DKESTXD/qiangao-mozhang/mozhang/classifier.h

#pragma once
#include <cstdarg>
namespace Eloquent {
    namespace ML {
        namespace Port {
            class SVM {
                public:
                    /**
                    * Predict class for features vector
                    */
                    int predict(float *x) {
                        float kernels[124] = { 0 };
                        float decisions[6] = { 0 };
                        int votes[4] = { 0 };
                        kernels[0] = compute_kernel(x,   -0.0  , 0.0  , 0.0  , 0.01  , 0.03  , 0.06  , 0.1  , 0.09  , 0.1  , 0.13  , 0.0  , 0.0  , 0.0  , 0.0  , 0.0  , 0.0  , 0.0  , 0.0  , 0.0  , 0.0  , 0.0  , 0.0  , 0.0  , 0.0  , 0.0  , 0.0  , 0.0  , 0.0  , 0.0  , 0.0  , 0.0  , 0.0  , 0.0  , 0.0  , 0.0  , 0.0  , 0.0  , 0.0  , 0.0  , 0.0  , 0.0  , 0.0  , 0.0  , 0.0  , 0.0  , 0.0  , 0.0  , 0.0  , 0.0  , 0.0  , 0.0  , 0.0  , 0.01  , 0.02  , 0.13  , 0.23  , 0.27  , 0.26  , 0.24  , 0.19  , 0.0  , 0.0  , 0.0  , 0.0  , 0.0  , 0.0  , 0.0  , 0.0  , 0.0  , 0.0  , 0.0  , 0.0  , 0.0  , 0.0  , 0.0  , 0.0  , 0.0  , 0.0  , 0.0  , 0.0  , 0.0  , 0.0  , 0.0  , 0.0  , 0.0  , 0.0  , 0.0  , 0.0  , 0.0  , 0.0  , 0.0  , 0.0  , 0.0  , 0.0  , 0.0  , 0.0  , 0.0  , 0.0  , 0.0  , 0.0 );
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
                        - kernels[117]
                        - kernels[118]
                        - kernels[119]
                        - kernels[120]
                        + kernels[121] * -0.670098301817
                        - kernels[123]
                        ;
                        votes[decisions[0] > 0 ? 0 : 1] += 1;
                        votes[decisions[1] > 0 ? 0 : 2] += 1;
                        votes[decisions[2] > 0 ? 0 : 3] += 1;
                        votes[decisions[3] > 0 ? 1 : 2] += 1;
                        votes[decisions[4] > 0 ? 1 : 3] += 1;
                        votes[decisions[5] > 0 ? 2 : 3] += 1;
                        int val = votes[0];
                        int idx = 0;

                        for (int i = 1; i < 4; i++) {
                            if (votes[i] > val) {
                                val = votes[i];
                                idx = i;
                            }
                        }

                        return idx;
                    }

                protected:
                    /**
                    * Compute kernel between feature vector and support vector.
                    * Kernel type: rbf
                    */
                    float compute_kernel(float *x, ...) {
                        va_list w;
                        va_start(w, 100);
                        float kernel = 0.0;

                        for (uint16_t i = 0; i < 100; i++) {
                            kernel += pow(x[i] - va_arg(w, double), 2);
                        }

                        return exp(-1.0 * kernel);
                    }
                };
            }
        }
    }
